M5Ross/AccDec_4Servos_4Relais/doc/IMG_20190709_185929.jpg

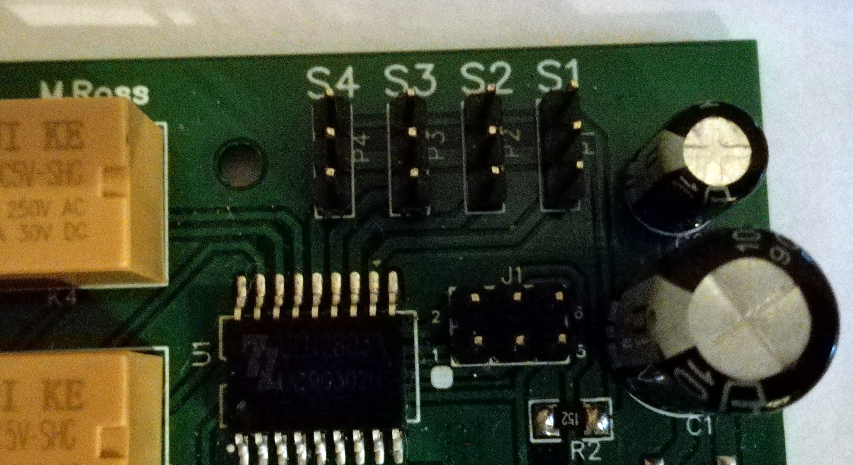
doc/IMG_20190709_185929.jpg
