M5Ross/AccDec_4Servos_4Relais/sch/Schematic_AccDec4Servo4rele_v30.pdf

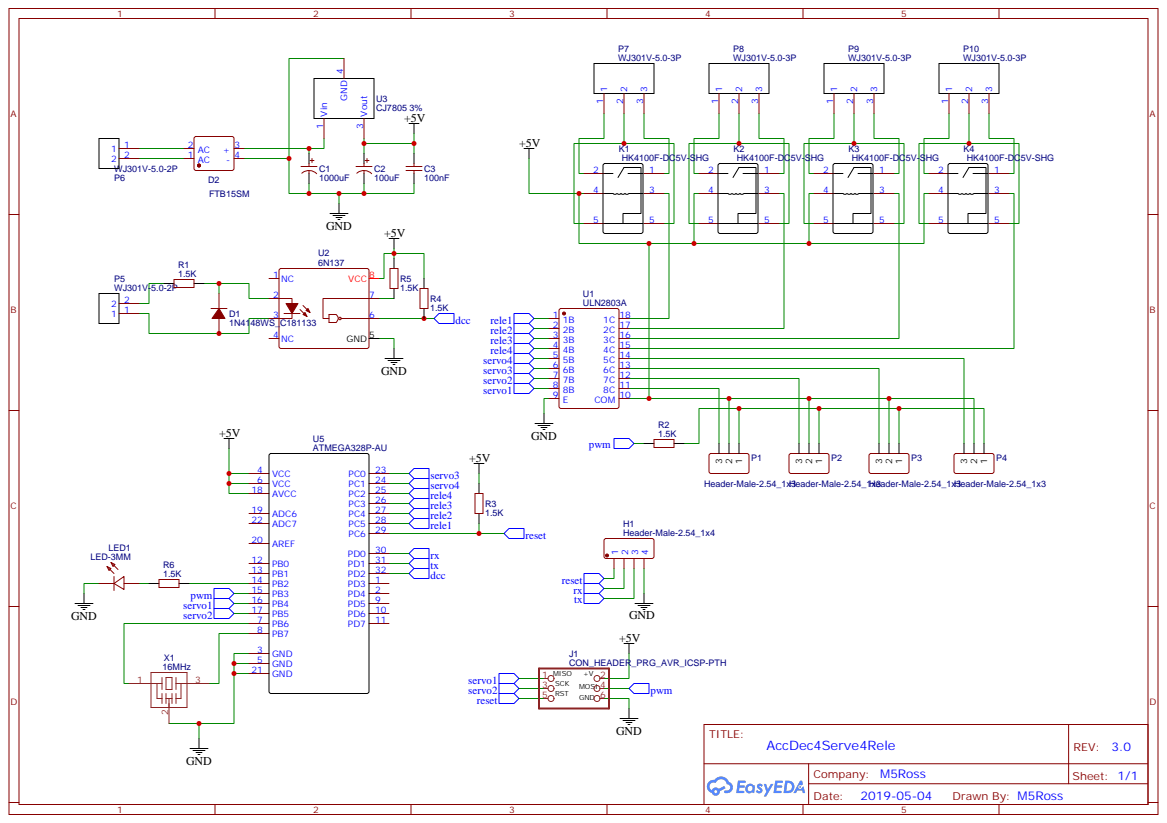
[picture p4: page 1]
