M5Ross/AccDec_4Servos_4Relais/doc/DECODER ACCESSORI DCC 4 SERVO 4 RELE - manuale v1.pdf

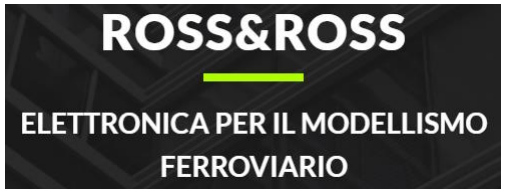
[picture p5: figure]

## DECODER ACCESSORI DCC 4 SERVO 4 RELE’

Questo decoder DCC può pilotare 4 sevomotori per la movimentazione degli scambi. Integrati nella scheda troviamo anche 4 relè che possono essere utilizzati per la polarizzazione del cuore degli scambi di tipo “elettrofrog”.

L’alimentazione del decoder può provenire direttamente dai binari o tramite un alimentatore esterno. La tensione di alimentazione raccomandata in caso di alimentatore/trasformatore esterno deve restare nei limiti 7V–15V. Il decoder è predisposto per essere alimentato sia in corrente continua che in corrente alternata. Per collegare i servomotori e i relè fere riferimento alla figura seguente.

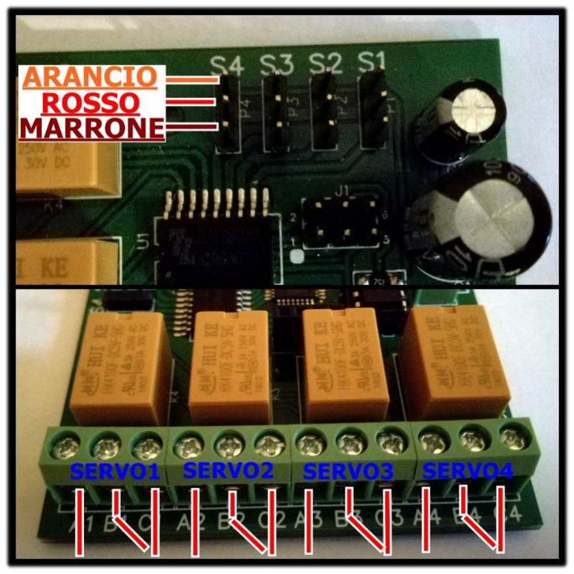
[picture p6: figure]

S1,S2,S3,S4 sono i connettori a 3 poli per i servi rispettivamente 1,2,3,4. La polarità corretta di inserimento è con il colore arancio

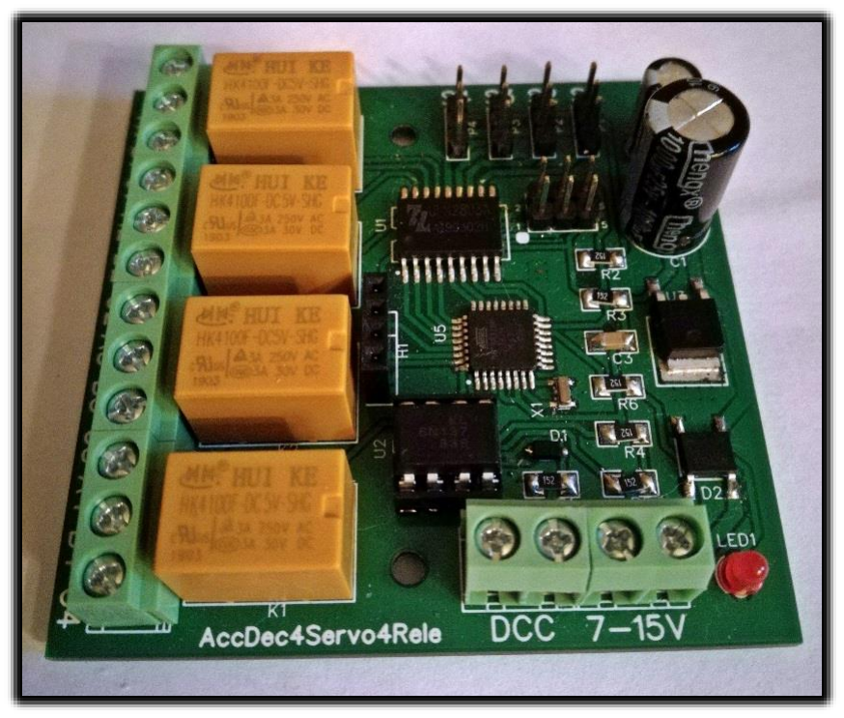
[picture p7: figure]

verso l’esterno del decoder. I connettori per i relè sono a 3 posizioni ciascuno Ax,Bx,Cx dove il numero corrisponde al relativo servo. La posizione normale del contatto è indicata in figura. Collegare il Je K del DCC ai terminali Ax e Cx mentre il cuore dello scambio al Bx. ATTENZIONE se doveste istallare il servomotore ruotato di 180° ricordatevi di invertire anche i collegamenti su Ax e Cx del connettore del relativo relè altrimenti avrete il cuore alimentato al contrario con conseguente cortocircuito sulle rotaie!
La configurazione del decoder può essere fatta andando a modificare i settaggi delle variabili di configurazione (CV) con l’ausilio di una qualsiasi centrale digitale atta alla loro programmazione. La tabella completa delle CV con le relative descrizioni la trovate qui sotto.
numero CV | valori possibili | valore default CV | spiegazione
1 9 | 1...255 0...64 | 1 0 | parte bassa indirizzo decoder servo parte alta indirizzo decoder servo
30 31 32 33 34 | 2 0...255 0...85 95...255 0...255 | 2 5 80 120 80 | Uscita 1: 2 = Servo (sola lettura) velocità rotazione Servo posizione sinistra posizione destra posizione all'accensione
35 36 37 38 39 | 2 0...255 0...85 95...255 0...255 | 2 5 80 120 80 | Uscita 2: 2 = Servo (sola lettura) velocità rotazione Servo posizione sinistra posizione destra posizione all'accensione
40 41 42 43 44 | 2 0...255 0...85 95...255 0...255 | 2 5 80 120 80 | Uscita 3: 2 = Servo (sola lettura) velocità rotazione Servo posizione sinistra posizione destra posizione all'accensione
45 46 47 48 49 | 2 0...255 0...85 95...255 0...255 | 2 5 80 120 80 | Uscita 4: 2 = Servo (sola lettura) velocità rotazione Servo posizione sinistra posizione destra posizione all'accensione
120 | 0...255 | 0 | Imposta 120 per resettare il decoder

L’indirizzo del decoder, definito dalle CV1 e 9 è quello assegnato all’uscita 1, le uscite 2, 3, 4 avranno gli indirizzi immediatamente successivi in ordine crescente. Per indirizzi fino a 255 è sufficiente scrivere il valore solo in CV1, lasciando la CV9 a zero. Per indirizzi da 256 in poi è necessario utilizzare anche la CV9 e a questo punto i valori da scrivere sono dati dalle seguenti due formule:

CV9 = parte intera di [( Indirizzo Uscita 1 )/255]
CV1 = (Indirizzo Uscita 1) - CV9x255

Per ogni uscita è possibile settare la velocità di movimento del servomotore CV31,36,41,46 dove maggiore è il numero più lento è
il | servo, | le | posizioni | ai | due | estremi | della | corsa
CV32,32,37,38,42,43,47,48 per lato sinistro e lato destro e la posizione di default all’accensione CV34,39,44,49. Infine scrivendo 120 nella CV120 si resetta il decoder alle impostazioni di fabbrica.

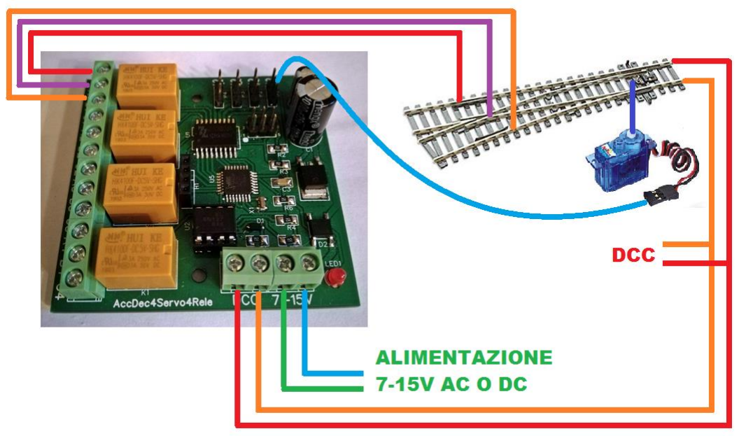
[picture p8: figure]

## ROSS&ROSS
