M5Ross/AccDec_4Servos_4Relais/(commit log)

2022-11-27 Add docs
    [AccDec_4Servos_4Relais.xlsx]
2022-11-27 Add gerbers and schematic
2022-12-04 Reorganized pcb and sch
